Che1012/spb/(list of files, drawings)

Other design files:
altium/control/spb_pcb.PcbDoc
altium/control/spb_project.PrjPcb
altium/control/spb_sch1.SchDoc
altium/sample/spb_sample_pcb.PcbDoc
altium/sample/spb_sample_project.PrjPcb
altium/sample/spb_sample_sch.SchDoc
altium/spb_project.PrjPcb
