Che1012/spb/(commit log)

2021-02-17 schm and pcb
    [spb_pcb.PcbDoc, spb_project.PrjPcb, spb_sample_pcb.PcbDoc, spb_sample_project.PrjPcb, spb_sample_sch.SchDoc, spb_sch1.SchDoc]
2021-03-19 spi is checking
2021-03-22 before spi test
2021-03-26 all measure devices added
